yuyoi/Pss-270-MegaDX/firmware/mega/pss270_mega/pss270_tones.h

// PLACEHOLDER voice table: every voice is the same plain organ-ish tone.
// The real PSS-270 tones are Yamaha's, so they are not in this repo. To get the real voices, build your
// own pss270_tones.h (same layout as below) from your own PSS-270, see docs/TONES.md.
// Layout: 8 YM2413 user-tone bytes (regs 0x00-0x07) per voice 00-99, then flags and a ROM-instrument number.
//   flags = what the ORIGINAL CPU does on top of the tone:
//     F_PARTIAL tone alone is not the whole voice   F_LAYER two channels   F_BUILTIN 2nd layer uses a ROM instrument
//     F_VIB CPU vibrato   F_PITCHEG CPU pitch envelope / LFO / dip   F_RETRIG CPU retriggers / block+1 tricks
#pragma once
#include <stdint.h>
#include <avr/pgmspace.h>
enum { F_PARTIAL=1, F_LAYER=2, F_BUILTIN=4, F_VIB=8, F_PITCHEG=16, F_RETRIG=32 };
struct Pss270Tone { uint8_t t[8]; uint8_t flags; uint8_t builtin; };
static const Pss270Tone PSS270_TONES[100] PROGMEM = {
  /*00*/ {{0x21,0x21,0x28,0x00,0xF0,0xF0,0x00,0x07}, 0, 0},
  /*01*/ {{0x21,0x21,0x28,0x00,0xF0,0xF0,0x00,0x07}, 0, 0},
  /*02*/ {{0x21,0x21,0x28,0x00,0xF0,0xF0,0x00,0x07}, 0, 0},
  /*03*/ {{0x21,0x21,0x28,0x00,0xF0,0xF0,0x00,0x07}, 0, 0},
  /*04*/ {{0x21,0x21,0x28,0x00,0xF0,0xF0,0x00,0x07}, 0, 0},
  /*05*/ {{0x21,0x21,0x28,0x00,0xF0,0xF0,0x00,0x07}, 0, 0},
  /*06*/ {{0x21,0x21,0x28,0x00,0xF0,0xF0,0x00,0x07}, 0, 0},
  /*07*/ {{0x21,0x21,0x28,0x00,0xF0,0xF0,0x00,0x07}, 0, 0},
  /*08*/ {{0x21,0x21,0x28,0x00,0xF0,0xF0,0x00,0x07}, 0, 0},
  /*09*/ {{0x21,0x21,0x28,0x00,0xF0,0xF0,0x00,0x07}, 0, 0},
  /*10*/ {{0x21,0x21,0x28,0x00,0xF0,0xF0,0x00,0x07}, 0, 0},
  /*11*/ {{0x21,0x21,0x28,0x00,0xF0,0xF0,0x00,0x07}, 0, 0},
  /*12*/ {{0x21,0x21,0x28,0x00,0xF0,0xF0,0x00,0x07}, 0, 0},
  /*13*/ {{0x21,0x21,0x28,0x00,0xF0,0xF0,0x00,0x07}, 0, 0},
  /*14*/ {{0x21,0x21,0x28,0x00,0xF0,0xF0,0x00,0x07}, 0, 0},
  /*15*/ {{0x21,0x21,0x28,0x00,0xF0,0xF0,0x00,0x07}, 0, 0},
  /*16*/ {{0x21,0x21,0x28,0x00,0xF0,0xF0,0x00,0x07}, 0, 0},
  /*17*/ {{0x21,0x21,0x28,0x00,0xF0,0xF0,0x00,0x07}, 0, 0},
  /*18*/ {{0x21,0x21,0x28,0x00,0xF0,0xF0,0x00,0x07}, 0, 0},
  /*19*/ {{0x21,0x21,0x28,0x00,0xF0,0xF0,0x00,0x07}, 0, 0},
  /*20*/ {{0x21,0x21,0x28,0x00,0xF0,0xF0,0x00,0x07}, 0, 0},
  /*21*/ {{0x21,0x21,0x28,0x00,0xF0,0xF0,0x00,0x07}, 0, 0},
  /*22*/ {{0x21,0x21,0x28,0x00,0xF0,0xF0,0x00,0x07}, 0, 0},
  /*23*/ {{0x21,0x21,0x28,0x00,0xF0,0xF0,0x00,0x07}, 0, 0},
  /*24*/ {{0x21,0x21,0x28,0x00,0xF0,0xF0,0x00,0x07}, 0, 0},
  /*25*/ {{0x21,0x21,0x28,0x00,0xF0,0xF0,0x00,0x07}, 0, 0},
  /*26*/ {{0x21,0x21,0x28,0x00,0xF0,0xF0,0x00,0x07}, 0, 0},
  /*27*/ {{0x21,0x21,0x28,0x00,0xF0,0xF0,0x00,0x07}, 0, 0},
  /*28*/ {{0x21,0x21,0x28,0x00,0xF0,0xF0,0x00,0x07}, 0, 0},
  /*29*/ {{0x21,0x21,0x28,0x00,0xF0,0xF0,0x00,0x07}, 0, 0},
  /*30*/ {{0x21,0x21,0x28,0x00,0xF0,0xF0,0x00,0x07}, 0, 0},
  /*31*/ {{0x21,0x21,0x28,0x00,0xF0,0xF0,0x00,0x07}, 0, 0},
  /*32*/ {{0x21,0x21,0x28,0x00,0xF0,0xF0,0x00,0x07}, 0, 0},
  /*33*/ {{0x21,0x21,0x28,0x00,0xF0,0xF0,0x00,0x07}, 0, 0},
  /*34*/ {{0x21,0x21,0x28,0x00,0xF0,0xF0,0x00,0x07}, 0, 0},
  /*35*/ {{0x21,0x21,0x28,0x00,0xF0,0xF0,0x00,0x07}, 0, 0},
  /*36*/ {{0x21,0x21,0x28,0x00,0xF0,0xF0,0x00,0x07}, 0, 0},
  /*37*/ {{0x21,0x21,0x28,0x00,0xF0,0xF0,0x00,0x07}, 0, 0},
  /*38*/ {{0x21,0x21,0x28,0x00,0xF0,0xF0,0x00,0x07}, 0, 0},
  /*39*/ {{0x21,0x21,0x28,0x00,0xF0,0xF0,0x00,0x07}, 0, 0},
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
};
