yuyoi/Pss-270-MegaDX/(commit log)

2026-10-08 Initial commit: PSS-270 Mega DX
    An Arduino Mega + ESP8266 takes over the YM2413 and the keyboard of a Yamaha PSS-270.
    Mega firmware (keys, MIDI, arpeggiator, key menu, voices), ESP firmware (console, live FM
    tone editor with draggable envelopes, WiFi setup, WiFi flashing of the Mega), and a
    pitch-measurement tool. Yamaha voice data is not included (placeholder table).
2026-10-08 Add the YM2413 pinout drawing
    docs/ym2413_pinout.png shows every YM2413 leg with its Arduino Mega pin, in the panel colours,
    and is shown in the README's wiring section. tools/make_pinout.py redraws it if the pin map changes.
2026-10-08 Standby works without a wire in stock mode; ESP health page and low-memory restart
    - Mega: the standby timer now also uses the CPU's /CS idle line (relayOn) when not parked, so it
    needs no extra wire. The A0 wire is only needed to notice a power-off while parked.
    - ESP: /sys shows uptime, heap, minimum heap, fragmentation, RSSI and last reset reason; the ESP
    restarts itself if free heap drops under 7 KB; the console page polls less often and pauses
    while its tab is hidden.
    - README: standby row, A0 note, and a known-issue note about the web-server freeze.
    [pss270_mega.ino, pss270_mega_esp.ino]
2026-10-10 Mega extras (fake filter, vibrato, glide, ADSR, layers, tunings, chords, Euclid arp), settings pages, Local WiFi mode, OLED address, sturdier WiFi startup
    [pss270_mega.ino, pss270_mega_esp.ino]
2026-11-06 README: link the jumper wires, lengths and types
2026-11-06 SEO: keyword heading, landing page (docs/index.html)
